TileParts/0104-USB-HUB/README.md

0104-USB-HUB
==========

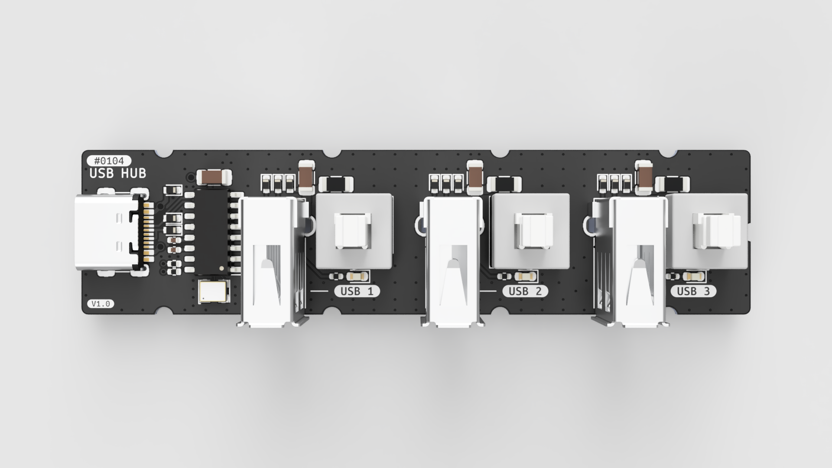
[picture p1: rendered.png]
0104-USB-HUB


一个带分控开关的一拖三 USB 2.0 Hub。

## 协议

[CERN-OHL-P-2.0](LICENSE)
