TileParts/0104-USB-HUB/0104-USB-HUB_SCH.pdf

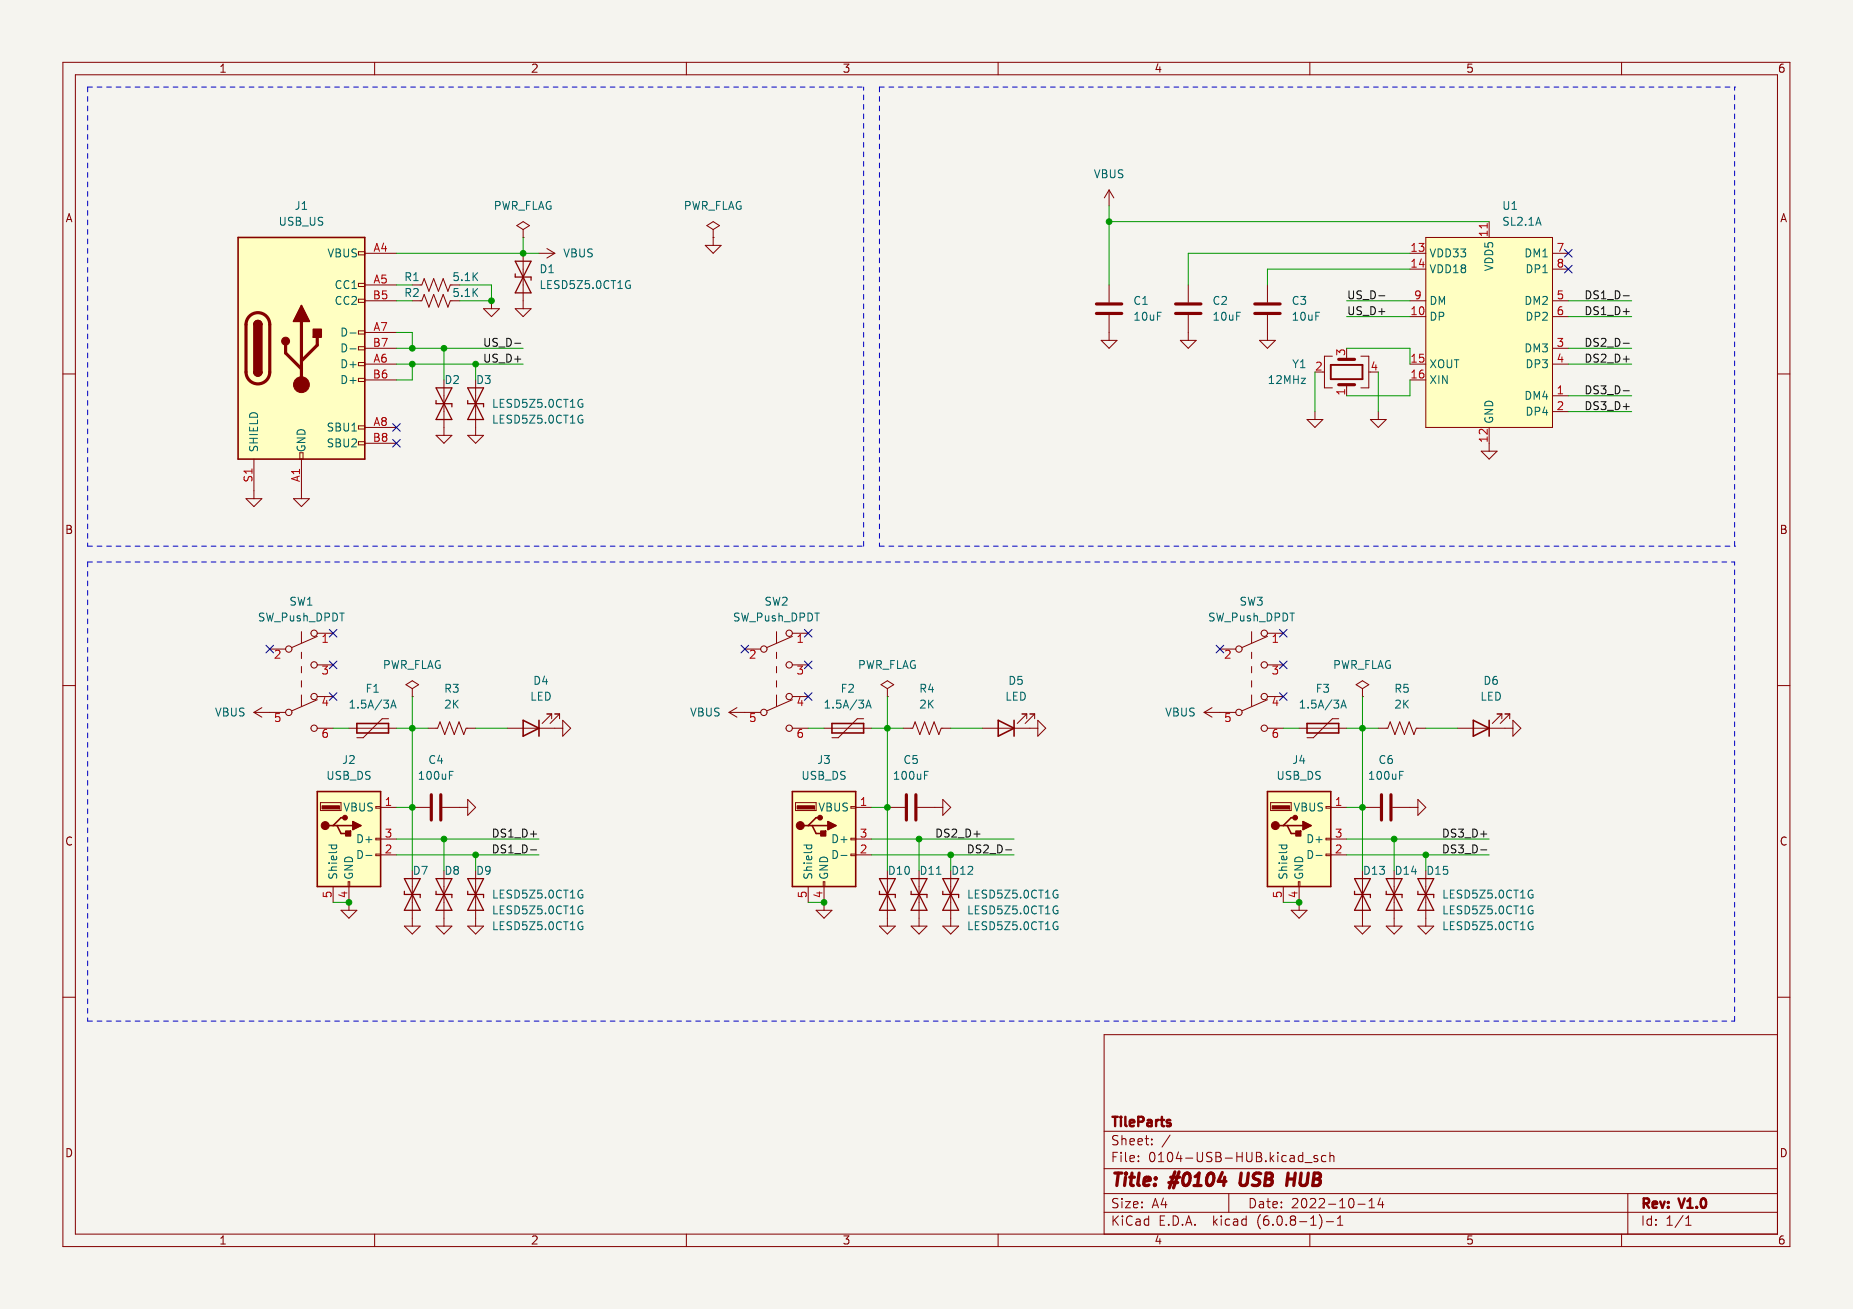
[picture p2: page 1]
