TileParts/0104-USB-HUB/0104-USB-HUB.kicad_pcb

## KiCad design 0104-USB-HUB.kicad_pcb (2022-10-16)

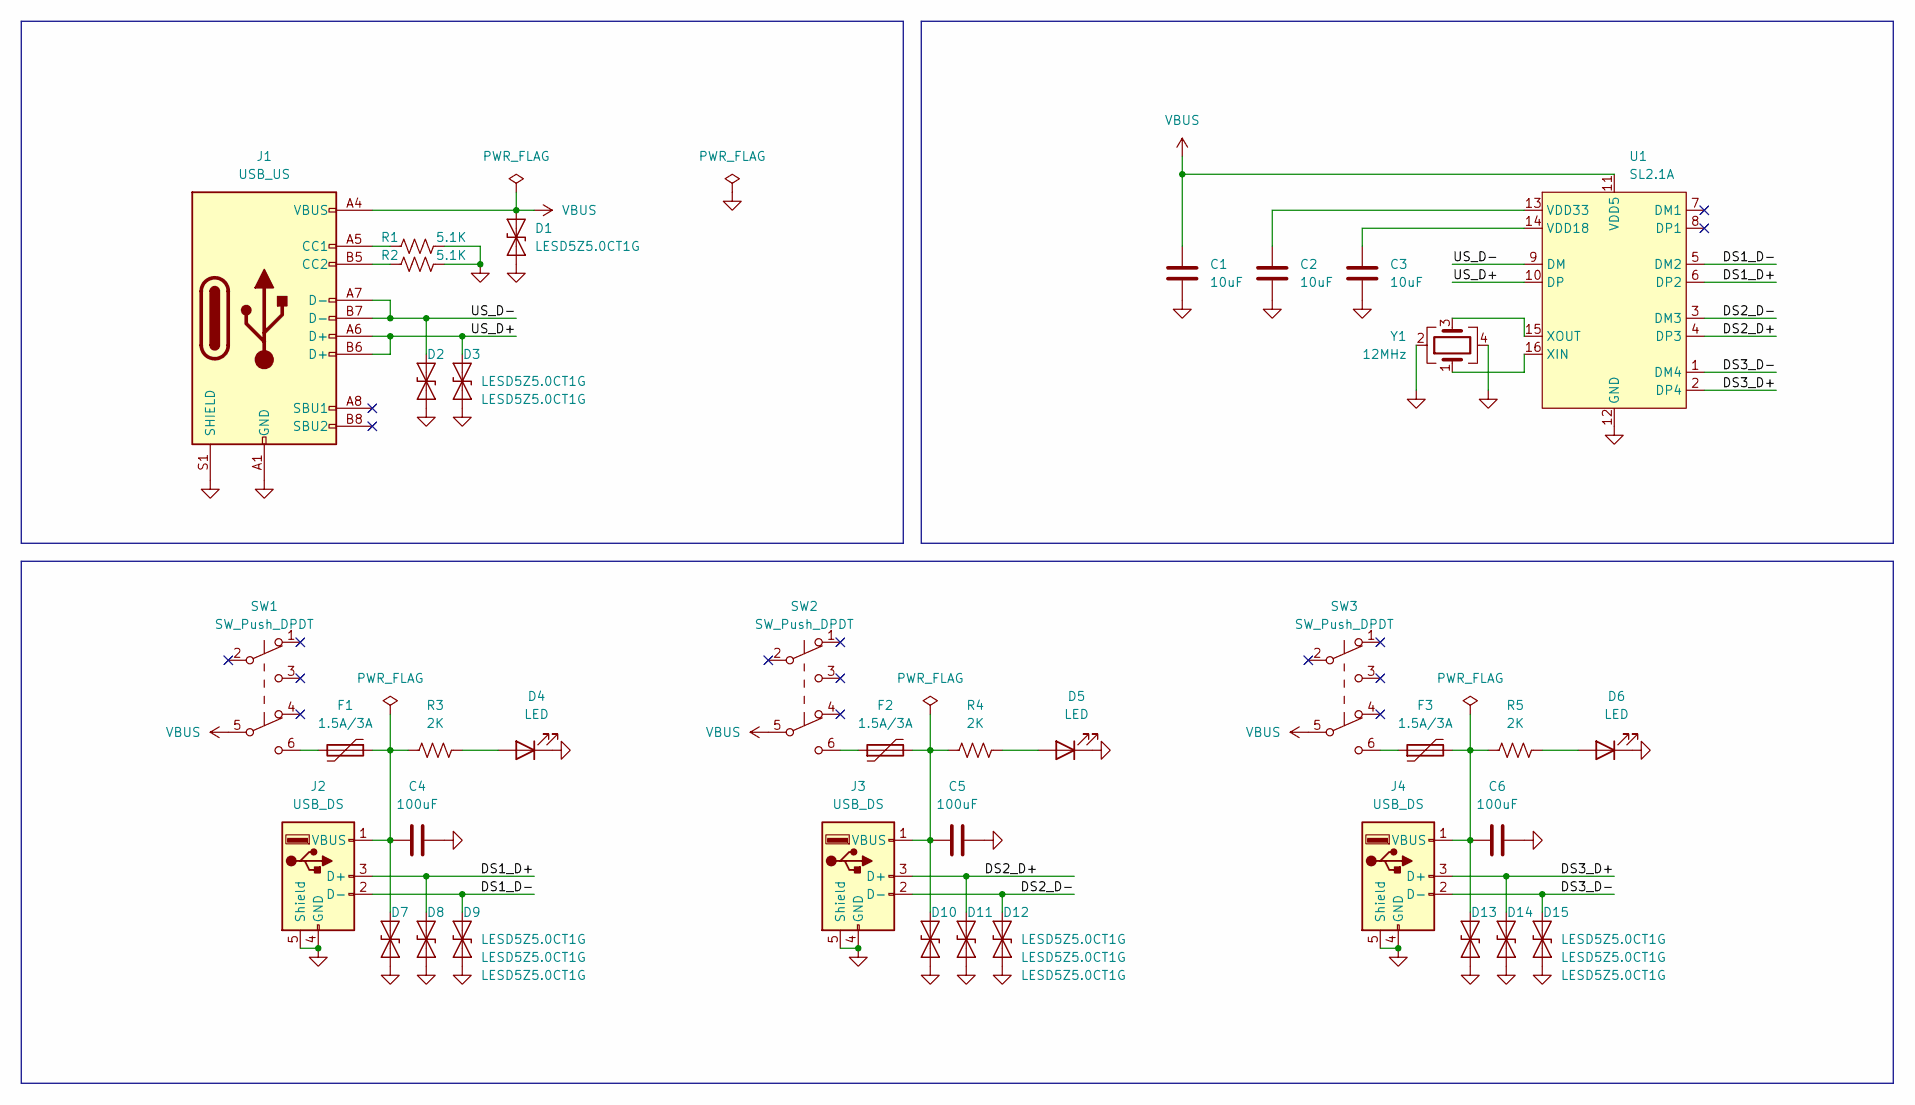
[picture p3: schematic 0104-USB-HUB.kicad_sch, #0104 USB HUB]

Parts:
C1: 10uF; C_1206_3216Metric; PartNumber C13585
C2, C3: 10uF; C_0402_1005Metric; PartNumber C15525
C4, C5, C6: 100uF; C_1206_3216Metric; PartNumber C15008
D1, D2, D3, D7, D8, D9, D10, D11, D12, D13, D14, D15: LESD5Z5.0CT1G; D_SOD-523; PartNumber C136167
D4, D5, D6: LED; LED_0603_1608Metric; PartNumber C72041
F1, F2, F3: 1.5A/3A; Fuse_1206_3216Metric; PartNumber C883133
J1: USB_US; HRO_TYPE-C-31-M-12; PartNumber C165948
J2, J3, J4: USB_DS; CKMTW_U-USBAN04P-F005; PartNumber C386739
R1, R2: 5.1K; R_0402_1005Metric; PartNumber C25905
R3, R4, R5: 2K; R_0402_1005Metric; PartNumber C4109
SW1, SW2, SW3: SW_Push_DPDT; SW_Push_DPDT_8.5x8.5mm; PartNumber C194405
U1: SL2.1A; SOP-16_3.9x9.9mm_P1.27mm; PartNumber C192893
Y1: 12MHz; Oscillator_SMD_3.2x2.5mm; PartNumber C9002

Connections:
/DS1_D+: D8.2 (A2), J2.3 (D+), U1.6 (DP2)
/DS1_D-: D9.2 (A2), J2.2 (D-), U1.5 (DM2)
/DS2_D+: D11.2 (A2), J3.3 (D+), U1.4 (DP3)
/DS2_D-: D12.2 (A2), J3.2 (D-), U1.3 (DM3)
/DS3_D+: D14.2 (A2), J4.3 (D+), U1.2 (DP4)
/DS3_D-: D15.2 (A2), J4.2 (D-), U1.1 (DM4)
/US_D+: D3.2 (A2), J1.A6 (D+), J1.B6 (D+), U1.10 (DP)
/US_D-: D2.2 (A2), J1.A7 (D-), J1.B7 (D-), U1.9 (DM)
GND: C1.2, C2.2, C3.2, C4.2, C5.2, C6.2, D1.1 (A1), D2.1 (A1), D3.1 (A1), D4.1 (K), D5.1 (K), D6.1 (K), D7.1 (A1), D8.1 (A1), D9.1 (A1), D10.1 (A1), D11.1 (A1), D12.1 (A1), D13.1 (A1), D14.1 (A1), D15.1 (A1), J1.A1 (GND), J1.A12 (GND), J1.B1 (GND), J1.B12 (GND), J1.S1 (SHIELD), J2.4 (GND), J2.5 (Shield), J3.4 (GND), J3.5 (Shield), J4.4 (GND), J4.5 (Shield), R1.2, R2.2, U1.12 (GND), Y1.2, Y1.4
unnamed: C2.1, U1.13 (VDD33)
unnamed: C3.1, U1.14 (VDD18)
unnamed: C4.1, D7.2 (A2), F1.1, J2.1 (VBUS), R3.1
unnamed: C6.1, D13.2 (A2), F3.2, J4.1 (VBUS), R5.1
unnamed: D4.2 (A), R3.2
unnamed: D5.2 (A), R4.2
unnamed: D6.2 (A), R5.2
unnamed: F1.2, SW1.6 (C)
unnamed: F2.1, SW2.6 (C)
unnamed: C5.1, D10.2 (A2), F2.2, J3.1 (VBUS), R4.1
unnamed: F3.1, SW3.6 (C)
unnamed: J1.A5 (CC1), R1.1
unnamed: J1.B5 (CC2), R2.1
unnamed: U1.15 (XOUT), Y1.3
unnamed: U1.16 (XIN), Y1.1
VBUS: C1.1, D1.2 (A2), J1.A4 (VBUS), J1.A9 (VBUS), J1.B4 (VBUS), J1.B9 (VBUS), SW1.5 (B), SW2.5 (B), SW3.5 (B), U1.11 (VDD5)

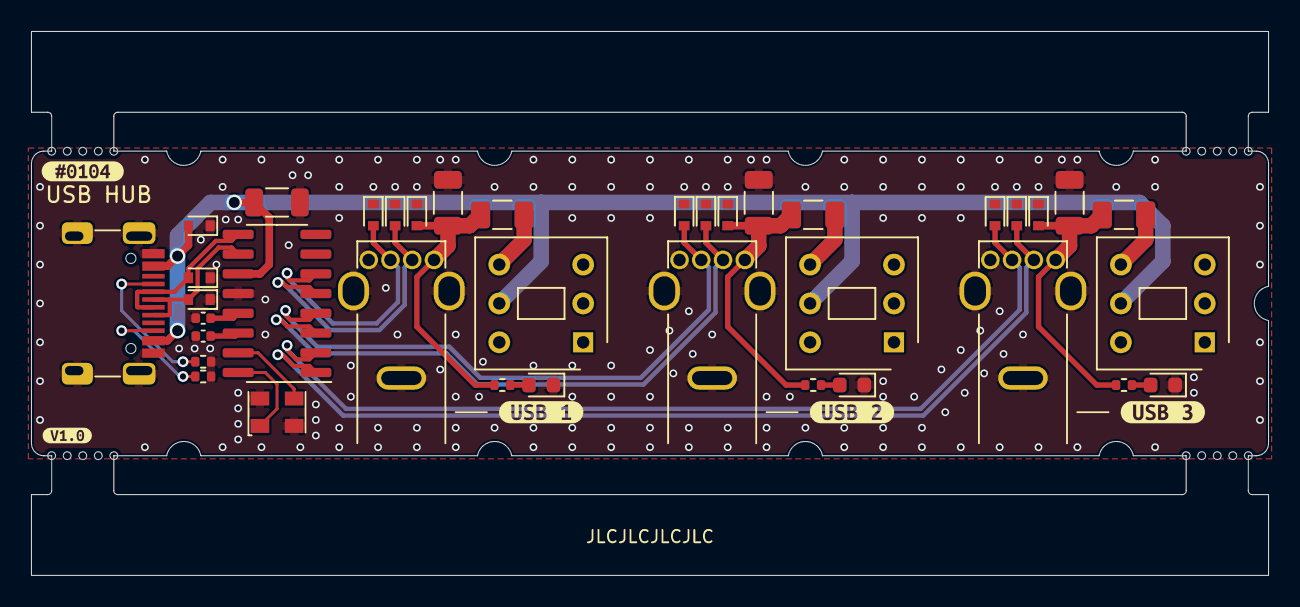
[picture p4: board 0104-USB-HUB.kicad_pcb from above]

Board: 2 copper layers, 79.6 x 35.0 mm, 43 parts (0 on the bottom side), 25 nets.

Other parts of the board:
kibuzzard-63351CB9: G***; kibuzzard-63351CB9
kibuzzard-63429E4C: G***; kibuzzard-63429E4C
kibuzzard-6343237B: G***; kibuzzard-6343237B
kibuzzard-6343237F: G***; kibuzzard-6343237F
kibuzzard-63432387: G***; kibuzzard-63432387
