TileParts/0104-USB-HUB/(commit log)

2022-10-13 Basic set up
    [0104-USB-HUB.kicad_pcb, 0104-USB-HUB.kicad_sch]
2022-10-13 Finish BOM
    [0104-USB-HUB.kicad_pcb, 0104-USB-HUB.kicad_sch]
2022-10-14 Finish SCH
    [0104-USB-HUB.kicad_pcb, 0104-USB-HUB.kicad_sch]
2022-10-16 Output docs
    [0104-USB-HUB-Bottom_Cu.gbr, 0104-USB-HUB-Bottom_Mask.gbr, 0104-USB-HUB-Bottom_Paste.gbr, 0104-USB-HUB-Bottom_Silk.gbr, 0104-USB-HUB-EdgeCuts.gbr, 0104-USB-HUB-NPTH.drl, 0104-USB-HUB-PTH.drl, 0104-USB-HUB-Top_Cu.gbr]
2022-10-16 Output schematic
